RoboTech-srl/opentracker/README.md

# OpenTracker
The first commercial grade, fully open source and 100% Arduino compatible GPS/GLONASS vehicle tracker with a powerful 32-bit ARM Cortex-M3 CPU.

The new IDE integration files are available at: https://github.com/robotech-srl/opentracker-arduino-board

All PCB files are available at: https://github.com/robotech-srl/opentracker-hardware

OpenTracker Wiki: https://github.com/robotech-srl/opentracker/wiki

Stable and tested firmware version: https://github.com/robotech-srl/opentracker/releases

Tracking cloud services provided by: [https://geolink.io](https://geolink.io)
