RoboTech-srl/opentracker/docs/old/OpenTracker 2.3 Dimensions.pdf

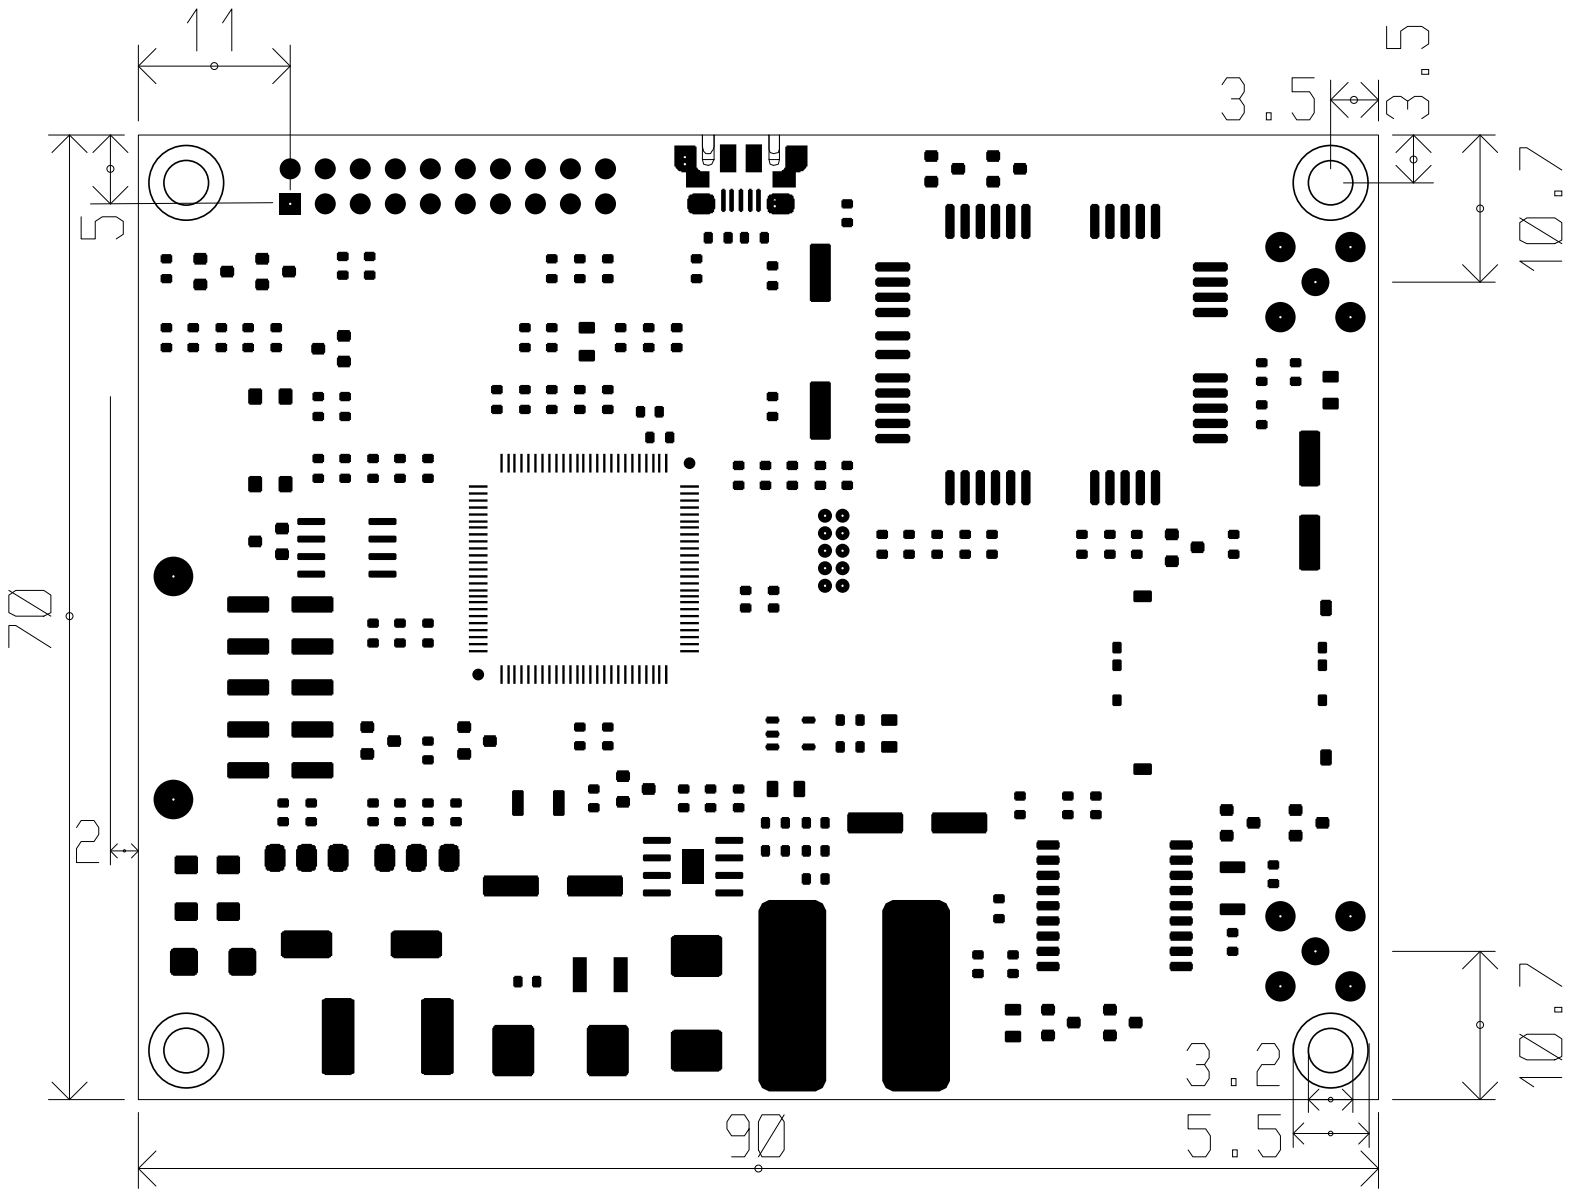
[picture p57: page 1]
