RoboTech-srl/opentracker/(commit log)

2018-02-13 fixed debug port initialization (must be before use)
    [OpenTracker.ino]
2018-02-13 optimized flash usage for settings and fixed initialization
    [OpenTracker.ino, settings.ino]
2018-02-13 fixed usage of data buffer to leave space for storage markers
    [data.ino]
2018-02-13 fixed typo on diagnostic output
    [storage.ino]
2018-02-13 fixed minor compiler warnings
    [gps.ino, led.ino, parse.ino, sms.ino]
2018-02-14 fixed warning for implicit conversion to double
    [OpenTracker.ino]
2018-05-02 moved documentation for old board revision
2018-08-23 fix build on STM32 platform
    [parse.ino, reboot.ino]
2018-08-23 fixed modem status on new hw version
    [gsm.ino]
2018-08-23 fixed support for all modem variants
    [gsm.ino, parse.ino]
2018-10-23 fixed warning about unused variable
    [data.ino]
2018-10-23 added support for power cut-off (new OpenTracker)
2018-10-23 increased modem power on timeout (for LTE)
2018-10-23 prevent APN auto-discovery if SIM has not changed
    [OpenTracker.ino, gsm.ino, settings.ino]
2018-10-23 fixed reading modem replies (especially with multi-tasking)
    [gsm.ino]
2018-10-23 fixed device initialization (new OpenTracker)
    [OpenTracker.ino]
2018-10-23 fixed socket connection status for all modem variants
    [gsm.ino]
2018-10-25 fixed 5V enable pin initialization
    [OpenTracker.ino]
2018-11-08 fixed ICCID reading with 4G modem variants
    [gsm.ino]
2018-11-13 fixed "always on" option causing modem to not respond anymore
    [OpenTracker.ino]
2018-11-13 fixed reading modem clock
    [gsm.ino]
2018-11-13 fixed modem time to use UTC before send
    [data.ino]
2018-11-15 fixed first run defaults for addon
    [settings.ino]
2018-11-16 fixed half connected sockets, assume they msut be closed before retry
    [gsm.ino]
2019-02-12 fixed BG96 (GSM only), removed factory date, fixed SIM identification
    [gsm.ino]
2019-02-12 fixed empty settings comparison, added read-only loading
    [settings.ino]
2019-02-12 fixed initial settings and SIM check, added APN reset option
    [OpenTracker.ino]
2019-02-21 fixed GPS reset issues disabling serial port pins
    [gps.ino]
2019-05-14 fixed debug macros with optimizations enabled
    [debug.h]
2019-05-14 removed workaround for 3G modem receive
    [parse.ino]
2019-07-02 introducing backup battery management
2019-07-02 fixed warning for float promotion to double
    [OpenTracker.ino]
2019-07-02 reworked NB-IoT options for BG96, added network search timeout
    [gsm.ino]
2019-07-26 fixed support for shorter BG96 scan sequence
    [gsm.ino]
